LudovicSaintBauzel/teleop-controller-bbb-xeno/GUI/paddle2/centering.jpg

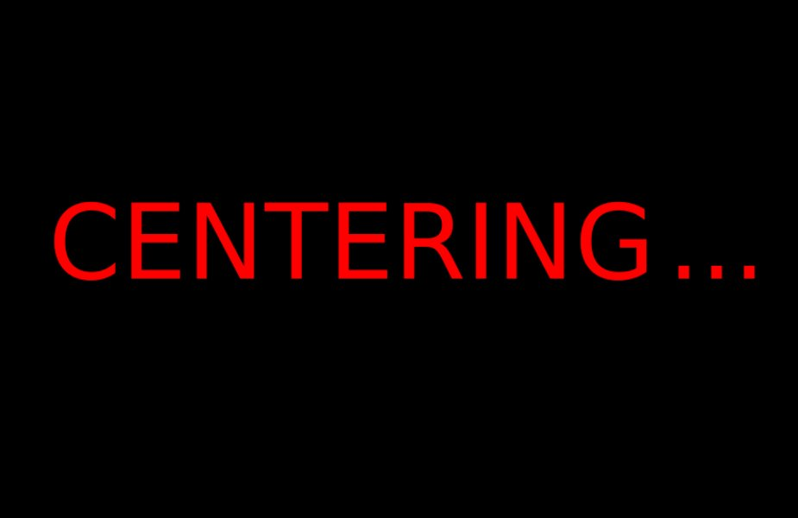
GUI/paddle2/centering.jpg
