LudovicSaintBauzel/teleop-controller-bbb-xeno/GUI/paddle2/IMG_OBST.jpg

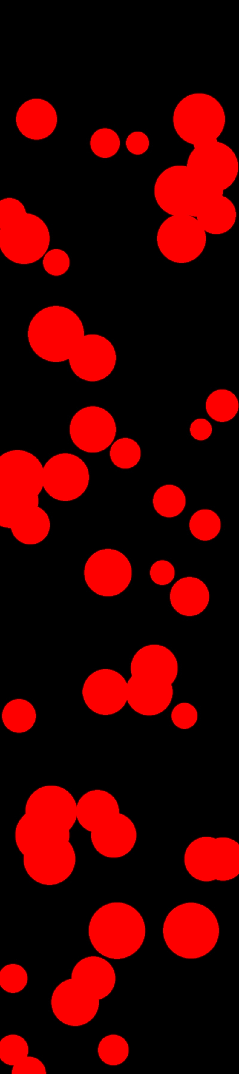
GUI/paddle2/IMG_OBST.jpg
