LudovicSaintBauzel/teleop-controller-bbb-xeno/GUI/paddle2/isir.jpg

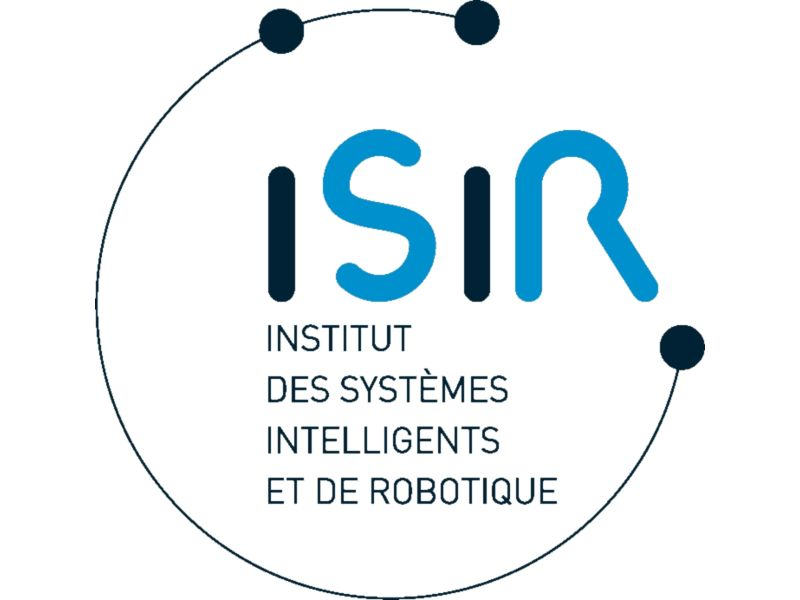
GUI/paddle2/isir.jpg
