LudovicSaintBauzel/teleop-controller-bbb-xeno/Solidworks files/Version 2 - direct drive/Assemblage_3.SLDASM

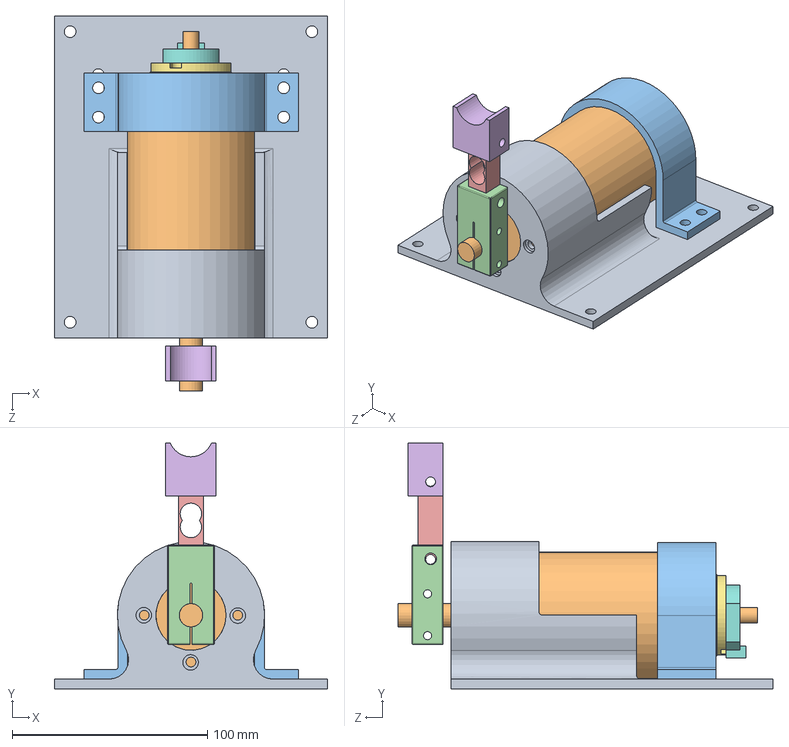
[picture p6: CAD file, 2017-07-10]
Solidworks files/Version 2 - direct drive/Assemblage_3.SLDASM
140.0 x 126.0 x 192.2 mm
Bati court
Moteur
Cale moteur
Pièce serrage poignée-moteur
Capteur force
Embout_court
Entretoise Moteur-Encodeur
Encoder
