LudovicSaintBauzel/teleop-controller-bbb-xeno/Solidworks files/Version 2 - direct drive/Assemblage-Moteur+Encoder.SLDASM

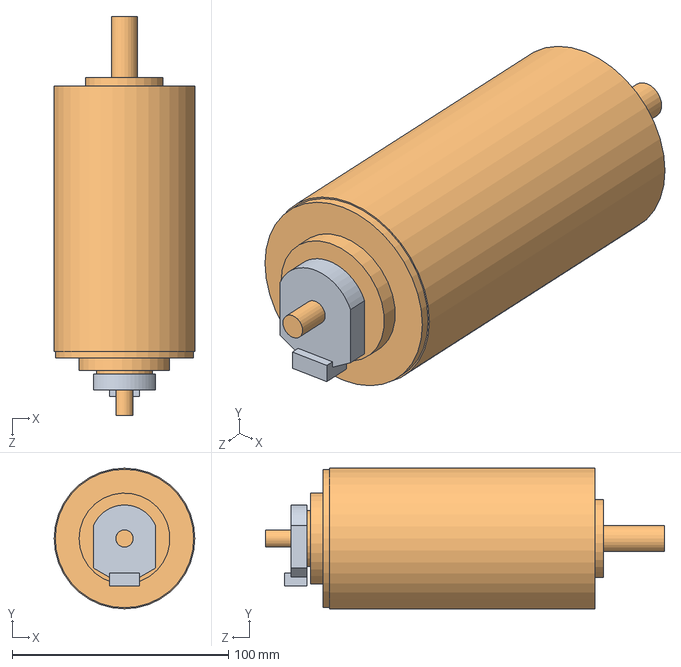
[picture p7: CAD file, 2017-07-10]
Solidworks files/Version 2 - direct drive/Assemblage-Moteur+Encoder.SLDASM
65.0 x 65.0 x 184.4 mm
Encoder
Moteur
