LudovicSaintBauzel/teleop-controller-bbb-xeno/Solidworks files/Version 1 - with cabstan reductor/Embout.SLDPRT

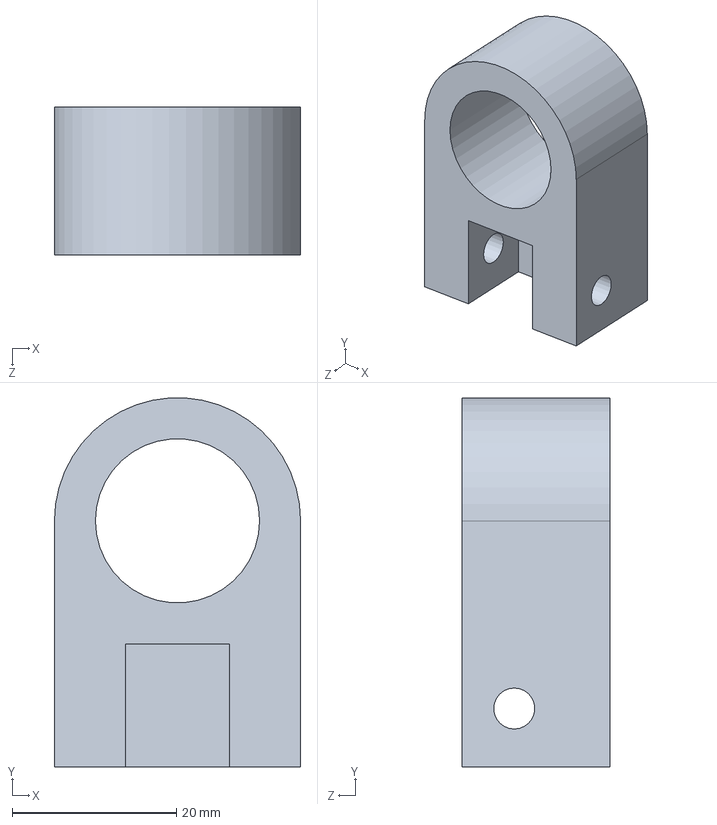
[picture p8: CAD file, 2017-07-10]
Solidworks files/Version 1 - with cabstan reductor/Embout.SLDPRT
30.0 x 45.0 x 18.0 mm
