LudovicSaintBauzel/teleop-controller-bbb-xeno/Solidworks files/Version 2 - direct drive/Bati court.SLDPRT

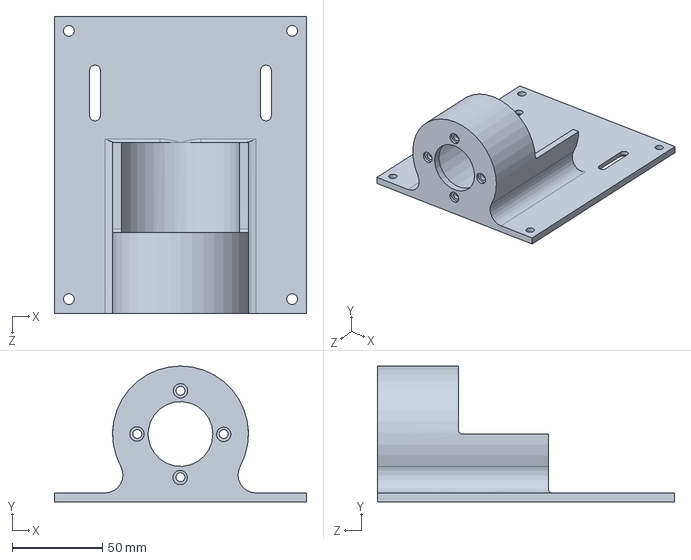
[picture p9: CAD file, 2017-07-10]
Solidworks files/Version 2 - direct drive/Bati court.SLDPRT
140.0 x 75.5 x 165.0 mm
