LudovicSaintBauzel/teleop-controller-bbb-xeno/Solidworks files/Version 1 - with cabstan reductor/Axe poignée.SLDPRT

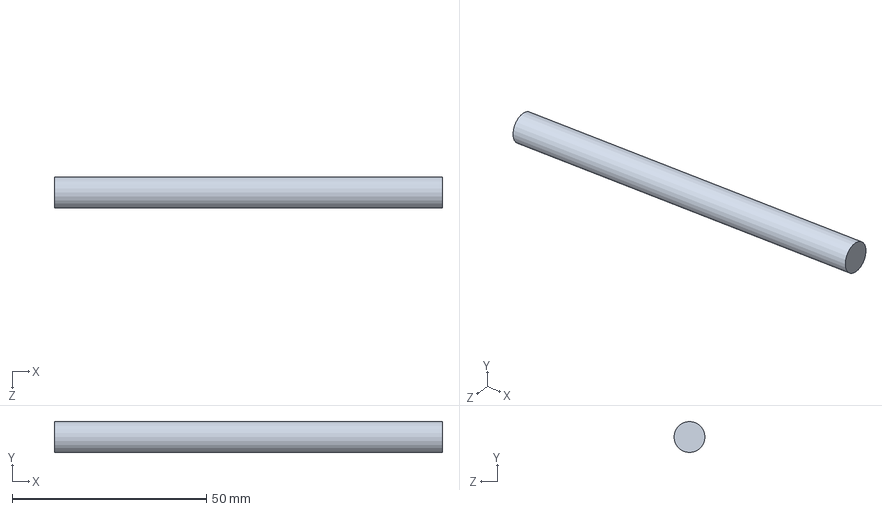
[picture p10: CAD file, 2017-07-10]
Solidworks files/Version 1 - with cabstan reductor/Axe poignée.SLDPRT
100.0 x 8.00 x 8.00 mm
