LudovicSaintBauzel/teleop-controller-bbb-xeno/Solidworks files/Version 1 - with cabstan reductor/Cale moteur.SLDPRT

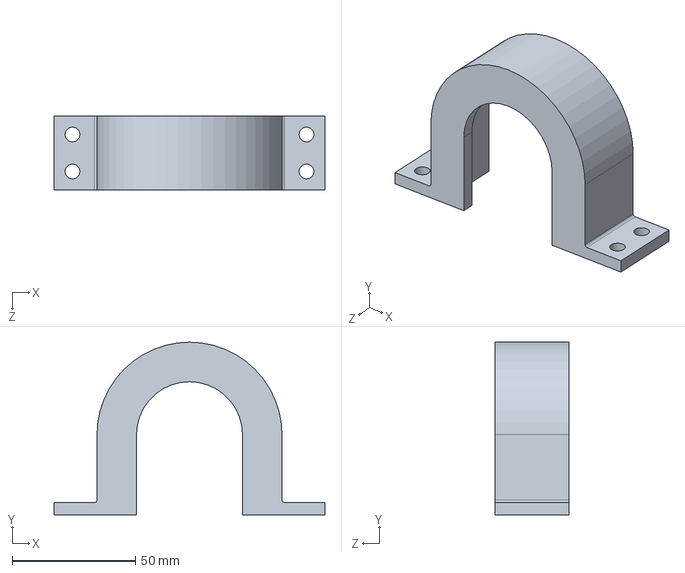
[picture p11: CAD file, 2017-07-10]
Solidworks files/Version 1 - with cabstan reductor/Cale moteur.SLDPRT
110.0 x 70.1 x 30.0 mm
