LudovicSaintBauzel/teleop-controller-bbb-xeno/Solidworks files/Version 2 - direct drive/Embout_court.SLDPRT

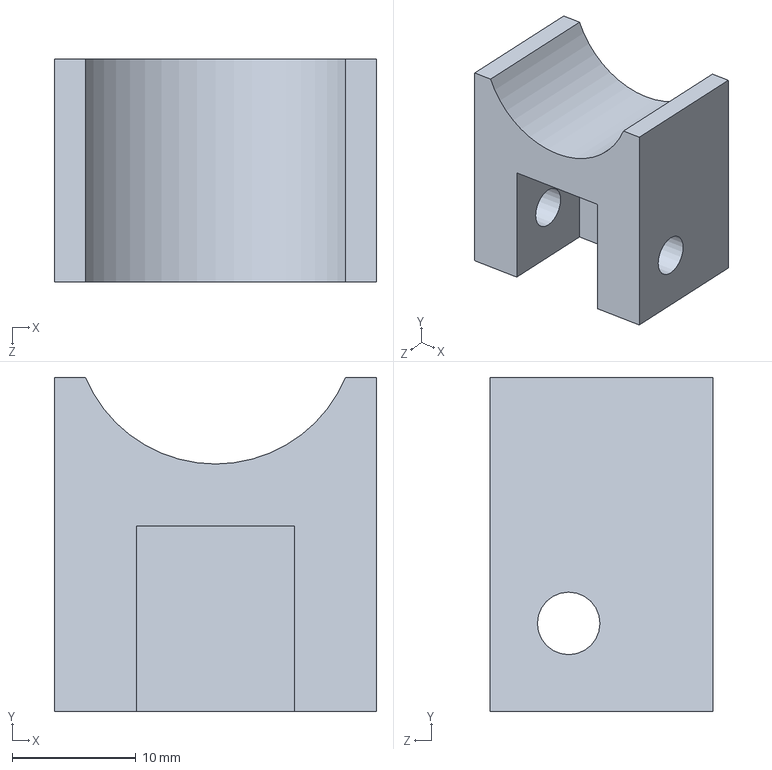
[picture p12: CAD file, 2017-07-10]
Solidworks files/Version 2 - direct drive/Embout_court.SLDPRT
26.0 x 27.0 x 18.0 mm
