LudovicSaintBauzel/teleop-controller-bbb-xeno/Solidworks files/Version 1 - with cabstan reductor/Capteur force.SLDPRT

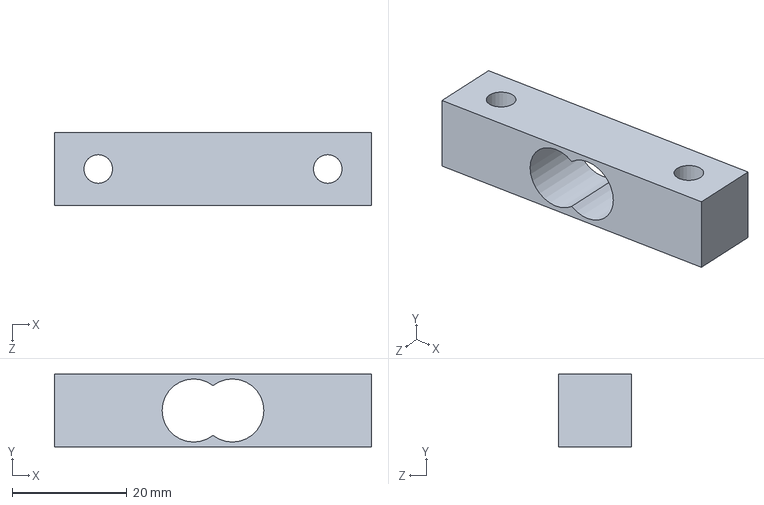
[picture p13: CAD file, 2017-07-10]
Solidworks files/Version 1 - with cabstan reductor/Capteur force.SLDPRT
55.2 x 12.7 x 12.7 mm
