LudovicSaintBauzel/teleop-controller-bbb-xeno/Solidworks files/Version 2 - direct drive/Encoder.SLDPRT

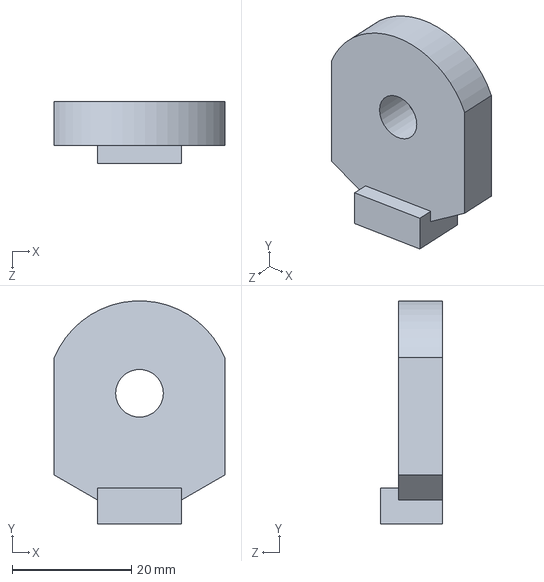
[picture p14: CAD file, 2017-07-10]
Solidworks files/Version 2 - direct drive/Encoder.SLDPRT
28.6 x 37.4 x 10.3 mm
