LudovicSaintBauzel/teleop-controller-bbb-xeno/Solidworks files/Version 1 - with cabstan reductor/Entretoise Moteur-Encodeur.SLDPRT

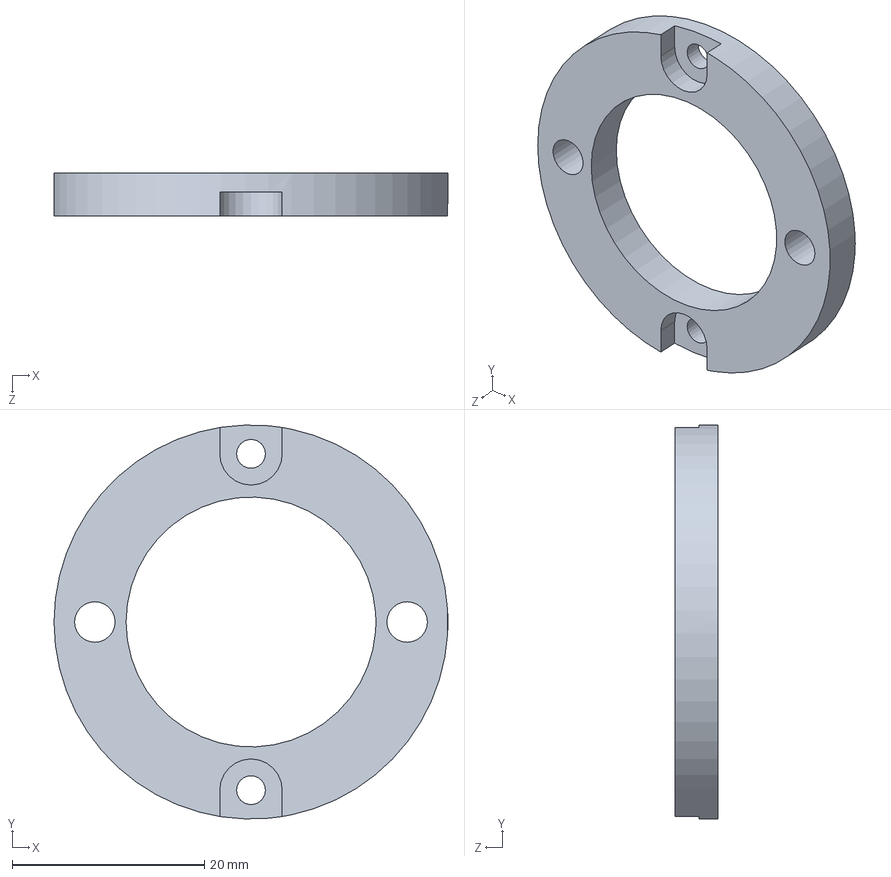
[picture p15: CAD file, 2017-07-10]
Solidworks files/Version 1 - with cabstan reductor/Entretoise Moteur-Encodeur.SLDPRT
41.0 x 41.0 x 4.50 mm
