LudovicSaintBauzel/teleop-controller-bbb-xeno/Solidworks files/Version 1 - with cabstan reductor/Moteur.SLDPRT

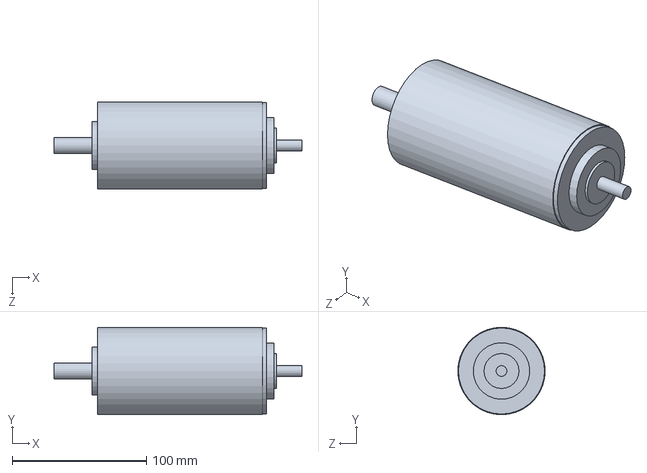
[picture p16: CAD file, 2017-07-10]
Solidworks files/Version 1 - with cabstan reductor/Moteur.SLDPRT
184.4 x 65.0 x 65.0 mm
