LudovicSaintBauzel/teleop-controller-bbb-xeno/Solidworks files/Version 2 - direct drive/Pièce serrage poignée-moteur.SLDPRT

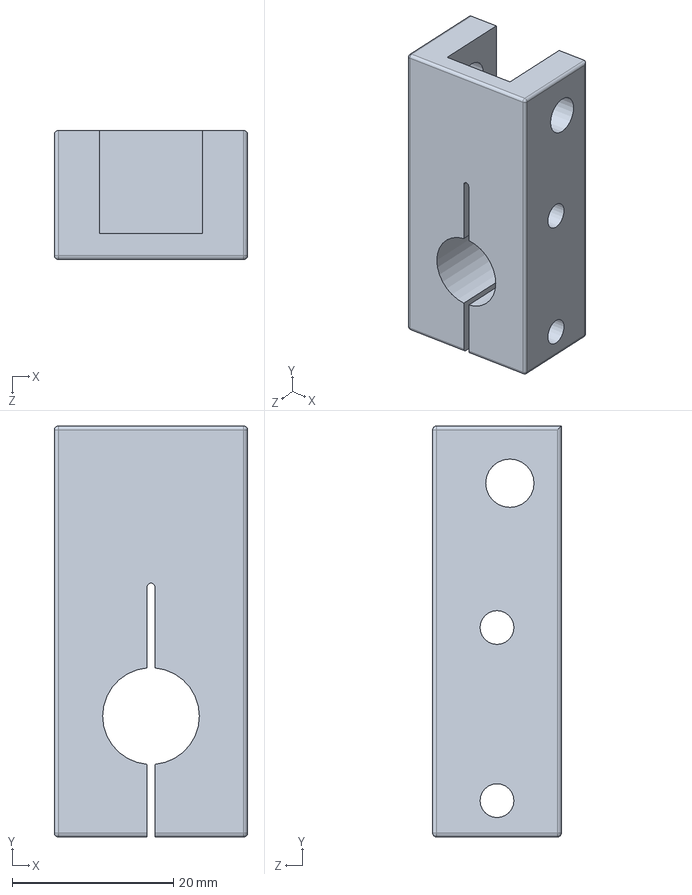
[picture p17: CAD file, 2017-07-10]
Solidworks files/Version 2 - direct drive/Pièce serrage poignée-moteur.SLDPRT
24.0 x 51.0 x 16.0 mm
