LudovicSaintBauzel/teleop-controller-bbb-xeno/Solidworks files/Version 1 - with cabstan reductor/Paddle.SLDPRT

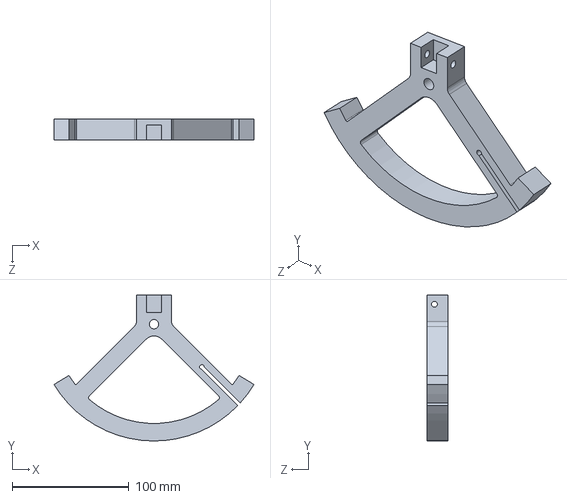
[picture p18: CAD file, 2017-07-10]
Solidworks files/Version 1 - with cabstan reductor/Paddle.SLDPRT
171.3 x 125.0 x 18.0 mm
