LudovicSaintBauzel/teleop-controller-bbb-xeno/Solidworks files/Version 1 - with cabstan reductor/Butée.SLDPRT

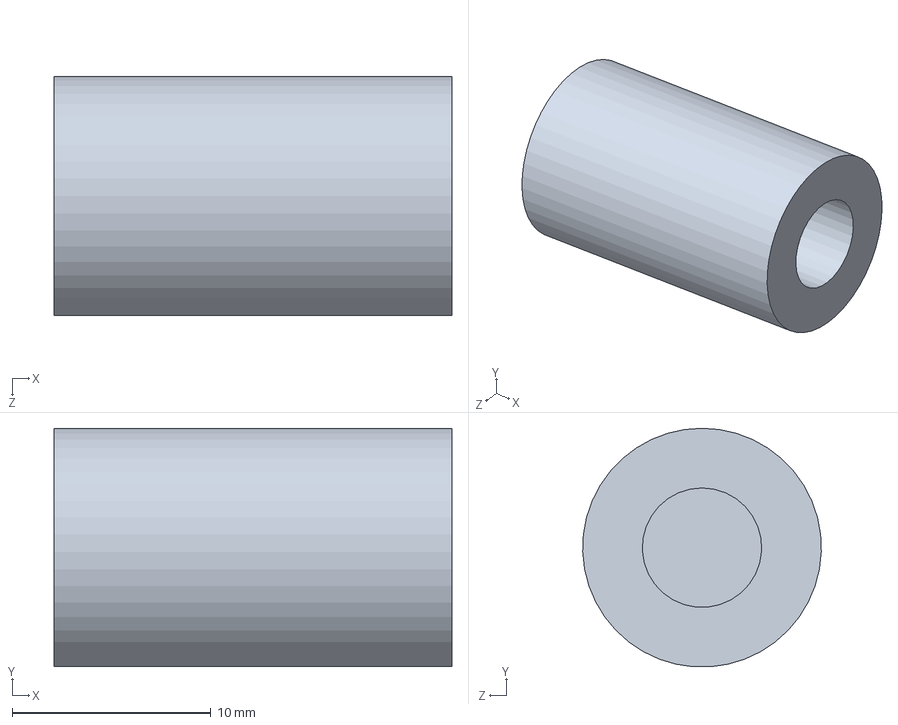
[picture p19: CAD file, 2017-07-10]
Solidworks files/Version 1 - with cabstan reductor/Butée.SLDPRT
20.0 x 12.0 x 12.0 mm
