LudovicSaintBauzel/teleop-controller-bbb-xeno/Solidworks files/Version 1 - with cabstan reductor/Plaque fixation poignee arrière.SLDPRT

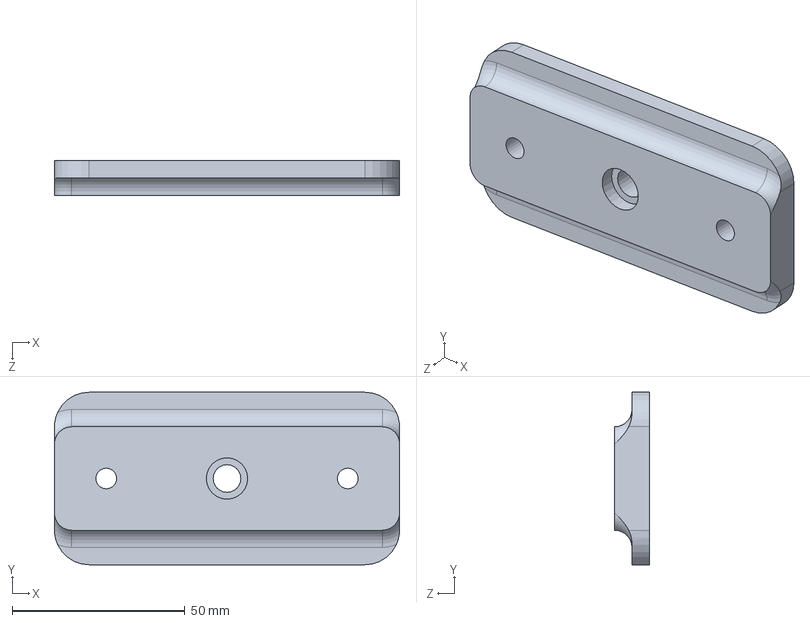
[picture p20: CAD file, 2017-07-10]
Solidworks files/Version 1 - with cabstan reductor/Plaque fixation poignee arrière.SLDPRT
100.0 x 50.0 x 10.0 mm
