LudovicSaintBauzel/teleop-controller-bbb-xeno/Solidworks files/Version 1 - with cabstan reductor/Enrouleur.SLDPRT

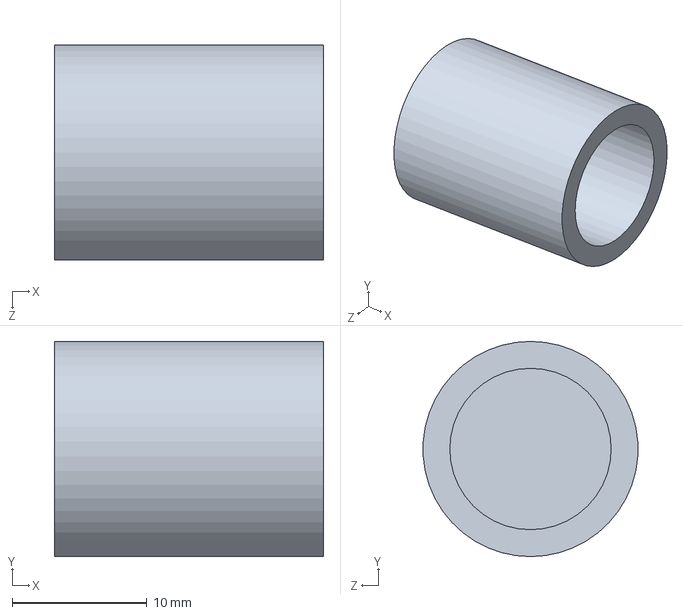
[picture p21: CAD file, 2017-07-10]
Solidworks files/Version 1 - with cabstan reductor/Enrouleur.SLDPRT
20.0 x 16.0 x 16.0 mm
