LudovicSaintBauzel/teleop-controller-bbb-xeno/Solidworks files/Version 1 - with cabstan reductor/Bati.SLDPRT

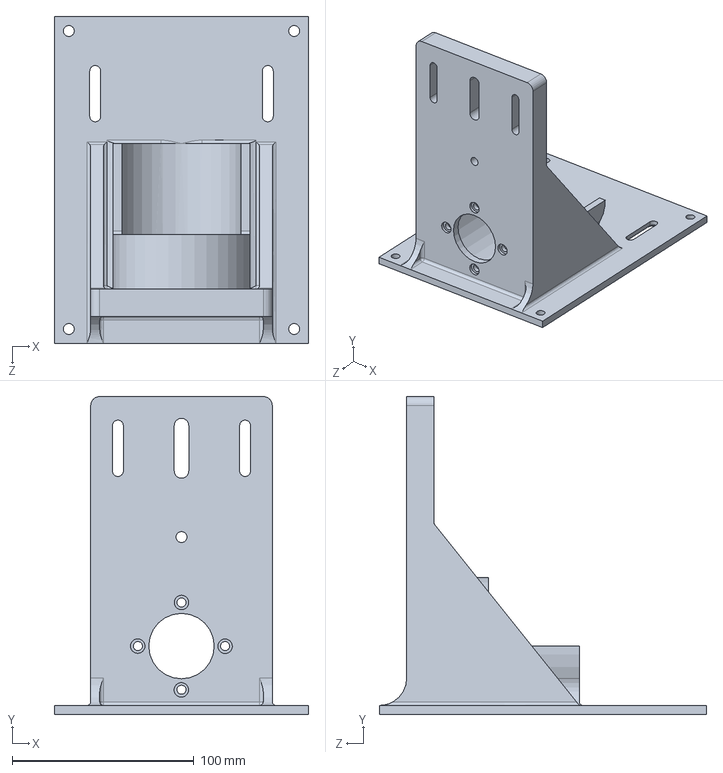
[picture p22: CAD file, 2017-07-10]
Solidworks files/Version 1 - with cabstan reductor/Bati.SLDPRT
140.0 x 175.0 x 180.0 mm
