LudovicSaintBauzel/teleop-controller-bbb-xeno/(list of files, cad)

Other CAD files:
Solidworks files/Version 1 - with cabstan reductor/Plaque fixation poignee.SLDPRT
Solidworks files/Version 1 - with cabstan reductor/M6 bolt.SLDPRT
