LudovicSaintBauzel/teleop-controller-bbb-xeno/Documentation/Acquisition-card.pdf

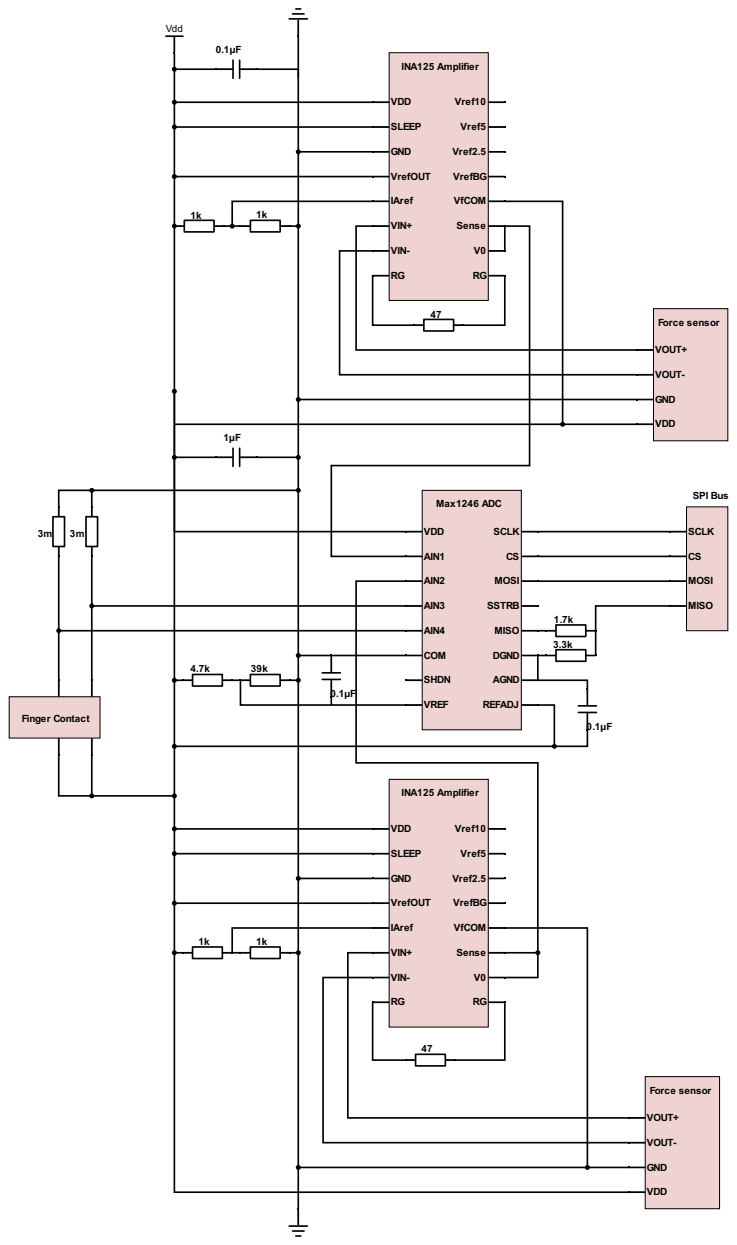
[picture p23: page 1]
SSTRB; VDD; AIN1; AIN2; AIN3; AIN4; COM; SHDN; VREF; SCLK; MOSI; MISO; DGND; AGND; REFADJ; Max1246 ADC; SLEEP; GND; VrefOUT; IAref; VIN+; VIN-; Vref10; Vref5; Vref2.5; VrefBG; VfCOM; Sense; INA125 Amplifier; Vdd; VOUT+; Force sensor; VOUT-; SPI Bus; Finger Contact
