LudovicSaintBauzel/teleop-controller-bbb-xeno/GUI/paddle2/Programme Interface Python Paddle/Robot/sources/divers.h

#ifndef _DIVERS_H_
#define _DIVERS_H_


extern double matrice_calibration[6][6];
/*{
	// chan1   chan2   chan3   chan4   chan5   chan6
	{+1.4908,+0.0015,+0.0066,+0.0007,-0.0062,-0.0002}, // Fx
	{-0.0055,+1.4857,+0.0020,-0.0074,+0.0013,-0.0038}, // Fy
	{-0.0050,-0.0194,+5.7759,+0.0112,-0.0056,+0.0105}, // Fz
	{-0.0035,-0.0146,-0.0113,+2.0538,-0.0045,+0.0150}, // Mx
	{+0.0267,+0.0025,+0.0075,+0.0035,+1.4131,-0.0011}, // My
	{-0.0001,-0.0048,-0.0055,-0.0009,-0.0017,+0.9340}  // Mz
};*/


void conversion_efforts( double *tab_src, double *tab_dest );


#endif
